dertheodor/dsm-diag/docs/e935.md

# E935 (European 2.0 16V) notes

E935 is the ROM ID of the European 1G Eclipse 2.0 16V non-turbo ECU
(MMC MD169144, MEC E2T36583). The same ECU is reported in the Galant E33 GTi 16V.
No public EPROM dump or disassembly exists as far as we know, so the address
map below is verified one address at a time. This page collects what we find.

All observations: 1991 Eclipse GS, Swiss spec, 2026-11-13.

## The line is inverted

The E935 speaks the same request/reply protocol as US ECUs ([protocol.md](protocol.md)),
at the same 1953 baud, but with inverted levels:

| | US ECUs | E935 |
|---|---|---|
| Pin 1 idle, diagnostic mode | High (the ECU pulls it up) | **0 V, floating** |
| Start bit, 0 bits | Low | **High (12 V, driven by the ECU)** |
| 1 bits, stop bit | High | **Low** |
| Wiring | 12 V or 5 V wiring | [Inverted wiring](wiring.md#inverted-wiring-e935) |

The E935 has a single output stage on pin 1 that can only drive the line high.
It uses this stage for the flash codes too. The proven
[MMCd-Go](https://github.com/kevin-buckham/MMCd-Go) cable has only a 10k
pull-down on pin 1, so US ECUs must hold pin 1 high themselves.

## Hardware observations

| Item | Observed |
|---|---|
| Pin 1, key on, no bridge | 12 V flash-code pulses |
| Pin 1, key on, pin 10 bridged | 0 V, floats: 1.6 MΩ and 6.3 MΩ to pin 12 (both probe directions) |
| Pin 10, ignition on | ~12 V (pulled up through the ECU) |
| Populated connector pins | 1, 5, 6, 10, 11, 12 |
| Requests in US polarity | Clean echo, no reaction at all, also no edges on the line |
| Requests in inverted polarity | The ECU replies 0.4–12 ms after the request ends |
| Line capacitance | About 50 nF, from edge timing. A 10k pull-down makes the falling edges about 0.9 ms late, which corrupts single 0-bits. 2k gives clean edges. |
| Request level | 3.3 V high caused misread requests. 5 V high gave 50 of 50 clean replies. |

## Version byte (0xFD)

Not read. The E935 profile does not send 0xFD: one bit error turns it into
0xFC (an actuator test) or 0xFF.

## Address map verification

Sessions:

- 2026-11-13: `firmware/sniffer` decoded by mid-bit sampling, then `npm run dashboard:e935`.
- 2026-11-14: `npm run verify`, Hamburg area, 3 °C outside, 1017 hPa
  (Open-Meteo). The logs are in [e935-logs/](e935-logs/).

The 2026-11-14 session sent about 34,000 requests with no misread of a request.
One abort happened: a log ran while the key was off, and the ECU drove pin 1 high
when the key was turned on. Since then the tools send nothing until the key is ON
([connect order](wiring.md#inverted-wiring-e935)).

| Address | US meaning | Reply | US scaling | E935 status | How verified |
|---|---|---|---|---|---|
| 0x14 | Battery voltage (×0.0733 V) | 0xA8 engine off, 0xC7 running | 12.3 V, 14.6 V | **confirmed** | Fluke: 12.46 V right after key off; charging voltage while running |
| 0x17 | Throttle position | 0x17 closed, 0xF7–0xFF fully pressed | 9 %, 97–100 % | **confirmed** | Gas pedal test, engine off, in the sniffer and the dashboard |
| 0x21 | Engine speed (×31.25 rpm) | 0x00 off, 0x2B–0x2D cold idle, 0x1A warm idle, 0x75 blip | 0, 1344–1406, 812, 3656 rpm | **confirmed** | Tachometer: about 1400 rpm at cold idle, on both days |
| 0x02 | Switch flags | 0xF0 key on | – | **bits 0x80 and 0x08 confirmed** | 0x80 idle switch: clears just before the throttle opens. 0x08 power steering: set only at full steering lock. 0x04 toggles only while the engine turns (US: TDC). 0x40 clears only while cranking. 0x20 and 0x10 never change (US: P/N and A/C; the car is a manual without A/C). |
| 0x13 | O2 sensor (×0.0195 V) | 0x01 cold; 0x02–0x28 after 45 s | 0.02 V; 0.04–0.78 V | **confirmed** | Steady 0 V cold, then switches about 145 times in 4 min. The same moment 0x0F starts to move. |
| 0x0F | O2 feedback trim | 0x80 open loop, 0x52–0x82 closed loop | 100 %, 64–102 % | **confirmed** | Leaves 0x80 exactly when 0x13 starts to switch |
| 0x07 | Coolant temp | 0xA0 cold-soaked, 0x1F–0x21 hot | US curve: 24 °C cold, 129 °C hot | **address plausible, US curve wrong** | Equals 0x3A on a cold-soaked engine at about 4 °C. Steady at 0x1F–0x21 for 5 min at hot idle. The dashboard shows the raw byte. |
| 0x3A | Intake air temp | 0xA1 cold-soaked, 0x9F–0x9B while idling | US curve: 30–36 °C | plausible, US curve wrong | Equals 0x07 on a cold-soaked engine. Rises slowly as the engine bay warms. |
| 0x15 | Barometer (×0.00486 bar) | 0xCB | 0.99 bar | plausible | Reference 1.017 bar: 3 % low. Read again on a day with different pressure to separate scale and offset. |
| 0x06 | Timing advance (−10 °) | 0x0F key on, 0x21–0x2C after start, 0x16 after 2 min, 0x32 blip | 5°, 23–34°, 12°, 40° BTDC | plausible | 5° is the 4G63 base timing. Check with a timing light. |
| 0x29 | Injector pulse width (×0.256 ms) | 0x98 cranking, 0x0D idle, 0x00 on throttle release | 39 ms, 3.3 ms, 0 | plausible | 0 is the fuel cut on deceleration |
| 0x1D | Accel enrichment | 0x00 idle, 0x11–0x16 blips | 0, 7–9 % | plausible | Non-zero only during the blips |
| 0x1A | MAF frequency (×6.29 Hz) | 0x00 off, 0x0B cold idle, 0x07 warm idle, 0x2B blip | 0, 69, 44, 270 Hz | plausible | Follows rpm and load |
| 0x26 | Knock sum | 0x00 idle, up to 0x04 in a blip | – | plausible | |
| 0x0C, 0x0D, 0x0E | Fuel trims low, mid, high | 0x96, 0x80, 0x8B, never changed | 117 %, 100 %, 108 % | plausible | Stored values. Not checkable at idle. |
| 0x16 | ISC steps | 0x78 idle, falls to 0x5D at full steering lock and to 0x5B with the lights on | 120, 93, 91 | unclear | Reacts to load, but falls where US ECUs rise |
| 0x00 | Flags (A/C clutch 0x20) | 0xBF key on, 0xA6–0xAF running, changes all the time | – | unknown | Bit 0x20 never changes |
| 0x38, 0x39, 0x3B, 0x3C | Fault code words | active 0x0000, stored 0x0008 | stored: code 14 (throttle position sensor) | read, mapping unverified | Cross-check with the flash codes (pin 10 open, meter on pin 1) |
| 0xCA | Clear fault codes | – | – | not sent | Clear codes is off in the E935 profile |

### Temperature curve

The US curves for 0x07 and 0x3A do not fit the E935. The raw value falls as the
temperature rises, as on US ECUs, but the US curve reads about 20 °C high when cold.
Raw points so far:

| Raw | Real temperature | Source |
|---|---|---|
| 0xA0 | about 4 °C | Cold-soaked overnight, 3.3 °C outside |
| 0x1F–0x21 | about 82–88 °C, assumed | Hot idle, gauge near half: steady for 5 min while the thermostat regulates |

The hot point assumes the thermostat temperature. A thermometer reading at hot idle
and points in between are needed before the dashboard shows °C.

## Hot start stall

The engine stalls or nearly stalls 2–3 s after a hot start. A cold start is clean.
Logs: [5-hot-start-stall](e935-logs/2026-11-14-5-hot-start-stall.csv),
[6-hot-start-and-hot-idle](e935-logs/2026-11-14-6-hot-start-and-hot-idle.csv).

| | Cold start | Hot start |
|---|---|---|
| Flare | 1656 rpm | 1188–1375 rpm |
| Lowest rpm after it | 1062 rpm | 400–560 rpm, or a stall |
| MAF ÷ rpm (raw) | 0.23–0.25, as at idle (0.26–0.27) | 0.11–0.14 |
| 0x16 | Stays at 120 | Falls to 104, then jumps to 120 while the engine dies |

- The engine gets about half the normal air for its rpm. The ignition timing is normal.
- With slight throttle, the first try still stalled. The second try hunted between 650 and 1440 rpm for 6 s, then held 720–780 rpm.
- At hot idle, 0x16 jumped from 78 to 120 in steps. rpm and MAF did not change.

Hypothesis: the idle air path (ISC servo, bypass passage, throttle body) passes too
little air when the fast-idle air valve is closed. A stuck ISC servo also explains
why 0x16 changes without effect. Check the ISC servo and clean the throttle body
before you test more.

## Allowlist

The E935 profile sends only these addresses: 0x02, 0x07, 0x0F, 0x13, 0x14, 0x17,
0x21, 0x38, 0x39, 0x3B and 0x3C. Of 0x02, the dashboard shows only the confirmed bits
(`E935_FLAGS`). Addresses in `E935_RAW` show the raw byte. The firmware is the hard gate (`allowed()` in
`firmware/dsm_bridge/dsm_bridge.ino`); `E935_ALLOWED` in `src/mmcd.ts` mirrors it.
The dashboard shows each sensor's status from `E935_STATUS` in `src/mmcd.ts`.

### Candidates

`firmware/sniffer` may also read the candidates: every US sensor, flag and fault
address that is at least two bit errors away from 0xCA, 0xF1–0xFC, 0xFE and 0xFF.
`E935_CANDIDATES` in `src/mmcd.ts` derives the list; the sniffer's `CANDIDATES`
must match it, and the self-test checks this. 0xFD is one bit error from 0xF5,
0xFC and 0xFF, so it is no candidate.

### To add an address

1. Upload the sniffer: `npm run fw -- sniffer`.
2. Watch the candidate live: `npm run verify -- 06,3A --log verify.csv`.
3. Confirm the value against a real measurement.
4. Add it to `allowed()`, `E935_ALLOWED` and `E935_STATUS`, and record the evidence in the table above.
5. Upload the bridge again: `npm run fw -- bridge --wiring inverted`.

## Next session at the car

Keep the [connect order](wiring.md#inverted-wiring-e935).
The 2026-11-14 session did the first checklist; the table above holds the results.
These checks remain:

- [ ] Coolant: thermometer on the upper hose at hot idle, and points while the engine warms up
- [ ] 0x06 timing: timing light at warm idle
- [ ] 0x15 barometer: read again on a day with clearly different air pressure
- [ ] 0x16 ISC: find out why it falls under load
- [ ] Fault codes: count the flash codes (pin 10 open, meter on pin 1) and compare with code 14
- [ ] Hot start: repeat the log after the ISC servo check or the throttle body cleaning
- [ ] Decide on the plausible addresses for the allowlist

## Later

- **Explore and RAM reads on the E935** (0x40–0xF0): reads on US ECUs, but each
  request carries a small misread risk. Decide after the checklist above, based
  on the misread record.
- **Datalogging while driving:** CSV recording works. Secure the laptop, keep
  the wires short, and do not watch the screen while driving.

## EPROM dump

Not dumped yet. When it is, record the chip type, programmer and checksum here,
and locate the diagnostic request handler and its address table by comparing
against the E931 source.
