dertheodor/dsm-diag/(commit log)

2026-11-13 feat: add E935 profile for the inverted diagnostic line
    The E935 leaves pin 1 floating in diagnostic mode and replies by driving
    it to 12 V, so US-polarity requests get no answer. WIRING_INVERTED drives
    the line through resistors only (D4 1k, D5 2k pull-down, D3 20k).
    Safety, in two gates: the firmware sends only allowlisted reads and
    locks itself when the ECU drives the line during a request; the
    software mirrors the allowlist, retries one missed reply, and halts on
    a misread. Explore and Clear codes are off in the E935 profile.
    [bridge-sim.cpp, dsm_bridge.ino]
2026-11-13 docs: document the inverted E935 line and its wiring
    Step 1 now measures in diagnostic mode and points to the matching
    wiring. Record the E935 measurements, the verified addresses and the
    allowlist rules.
2026-11-13 feat(firmware): add line sniffer for silent ECUs
    dsm_bridge drops every frame that is not a valid 1953-baud byte. The
    sniffer logs every edge on pin 1 after read-only requests, so an ECU
    that answers in another format becomes visible.
2026-11-13 feat(firmware): sniff the line in both polarities
    The E935 stays silent on a normal idle-high line. Mode B holds the line
    low with a 10k pull-down, sends inverted bytes through D4, and listens
    for the ECU driving the line high.
    [sniffer.ino]
2026-11-13 feat(firmware): make the sniffer safe for the inverted E935 line
    Switch the pull-down with D5 so requests reach the full 5 V, wait for
    a start command, send only whitelisted reads without 0xFD, and stop
    when the ECU drives the line during a request. Mode A is removed: it
    needed the ULN2003, which can short the ECU output.
    [sniffer.ino]
2026-11-13 docs(readme): list the inverted bridge wiring
2026-11-13 fix: halt the E935 profile only on the bridge abort signature
    Any echo mismatch halted the dashboard, so a wiring fault or an
    unpowered ECU showed the misread message instead of the wiring hint.
    Only the inverted echo from the bridge means a misread.
2026-11-13 docs(e935): confirm engine speed and battery with the engine running
2026-11-14 feat(sniffer): add a live verify mode for E935 candidates
    The sniffer reads a list of candidate addresses in a loop and decodes
    the inverted replies on the device. Candidates are every US sensor,
    flag and fault address at least two bit errors from a blocked address.
    The firmware checks the list and the bit distance; it locks itself
    after a misread. A host simulation covers decoding, refusals and the
    abort, and the self-test checks that the firmware lists match the
    TypeScript lists.
    [sniffer-sim.cpp, sniffer.ino]
2026-11-14 feat: add verify and fw commands and E935 status badges
    npm run verify shows candidate addresses live, and sends nothing until
    the sniffer announces itself. npm run fw compiles and uploads a
    firmware; the bridge needs an explicit wiring. The dashboard marks
    each E935 sensor as confirmed or plausible.
2026-11-14 docs(e935): record the 2026-11-14 verify session
    Confirm 0x02 (idle and power steering bits), 0x13 and 0x0F. Record
    plausible results for ten more addresses, the wrong US temperature curve
    and the remaining checks. Add the session logs as evidence.
2026-11-14 feat(e935): allow the confirmed addresses and wait for the key
    Add 0x02, 0x13 and 0x0F to both gates. Show only the confirmed 0x02 bits,
    and the raw coolant byte, because the US curve is wrong on the E935.
    The E935 dashboard now sends nothing until the user confirms the key is
    ON, and waits for the user again after a no-reply. verify and the CLI
    stop when the ECU stops replying. A request during the ECU's power-up
    caused a misread abort in the 2026-11-14 session.
    [dsm_bridge.ino]
2026-11-14 docs(e935): add the hot point, the hot start stall and the session logs
    The logs were ignored by the *.csv rule, so the links from the last
    session pointed nowhere.
    [2026-11-14-1-key-on.csv, 2026-11-14-2-switches.csv, 2026-11-14-3-cold-start-idle.csv, 2026-11-14-4-warm-up.csv, 2026-11-14-5-hot-start-stall.csv, 2026-11-14-6-hot-start-and-hot-idle.csv]
